gralco/click-clock-board/README.md

# click-clock-board

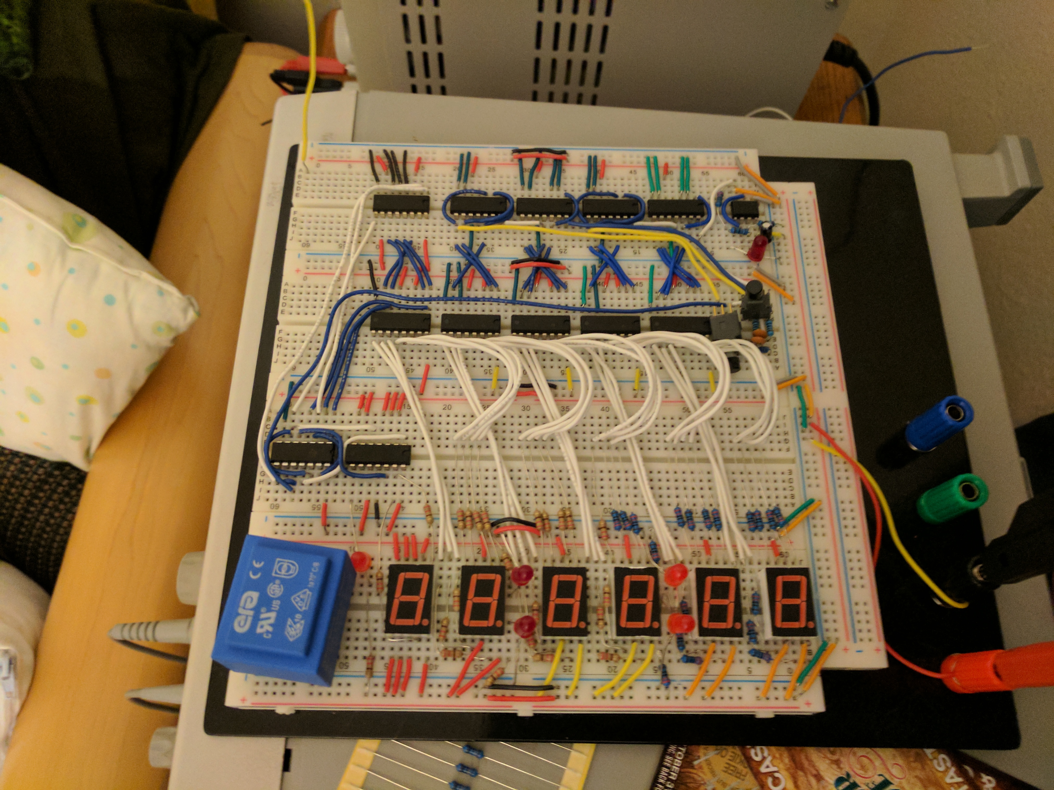
[picture p1: photos/bread_board.jpg]
Bread Board
