gralco/click-clock-board/mojo_io_shield/work/planAhead/Elevator/Elevator.runs/impl_1/.par.begin.rst

<?xml version="1.0"?>
<ProcessHandle Version="1" Minor="0">
    <Process Command="par" Owner="ekuzmenko" Host="localhost.localdomain" Pid="26856">
    </Process>
</ProcessHandle>
