gralco/click-clock-board/mojo_io_shield/work/planAhead/Elevator/Elevator.runs/synth_1/.xst.begin.rst

<?xml version="1.0"?>
<ProcessHandle Version="1" Minor="0">
    <Process Command="xst" Owner="ekuzmenko" Host="localhost.localdomain" Pid="25767">
    </Process>
</ProcessHandle>
