gralco/click-clock-board/gtkwave/hours.png

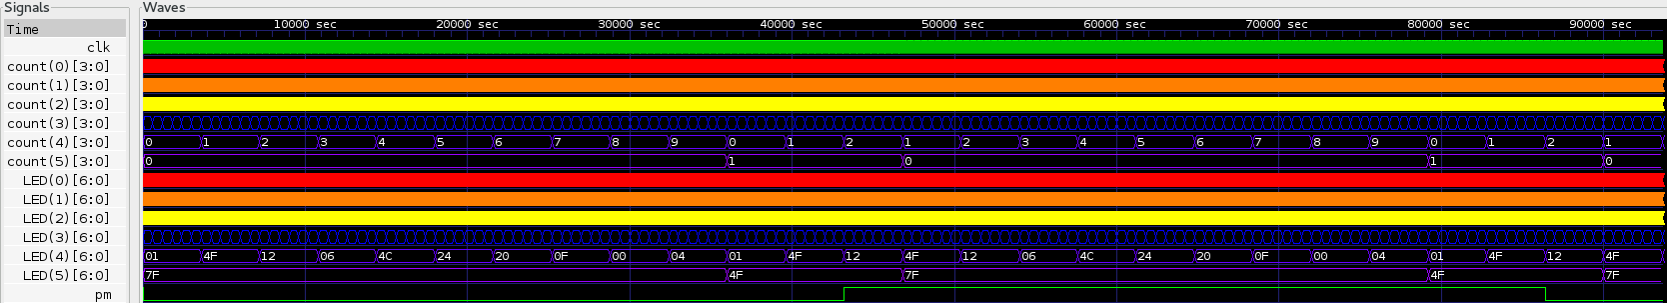
gtkwave/hours.png
