gralco/click-clock-board/gtkwave/minutes.png

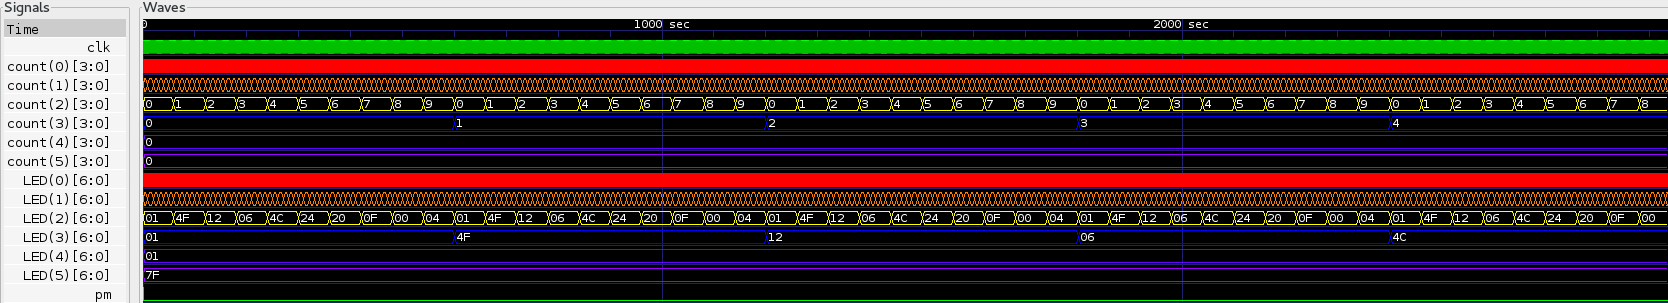
gtkwave/minutes.png
