gralco/click-clock-board/gtkwave/seconds.png

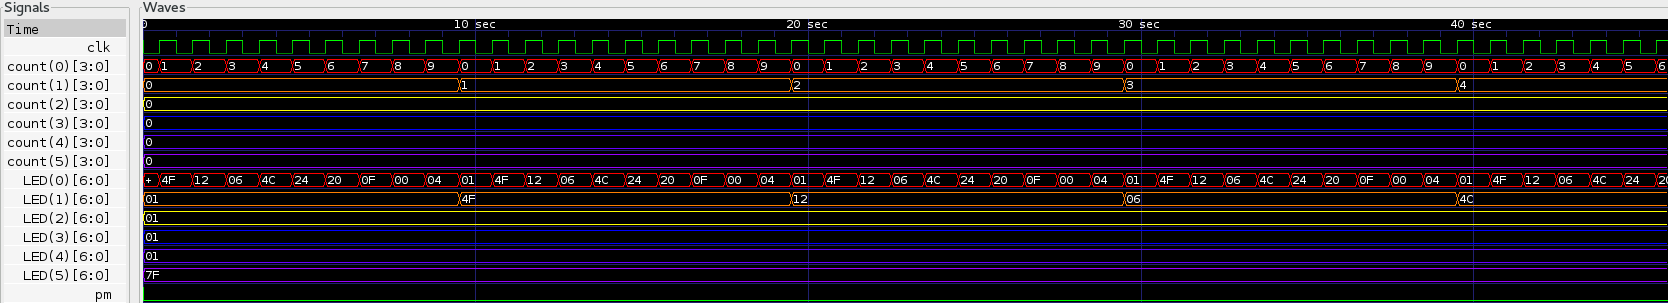
gtkwave/seconds.png
