gralco/click-clock-board/logisim/clock_bw.png

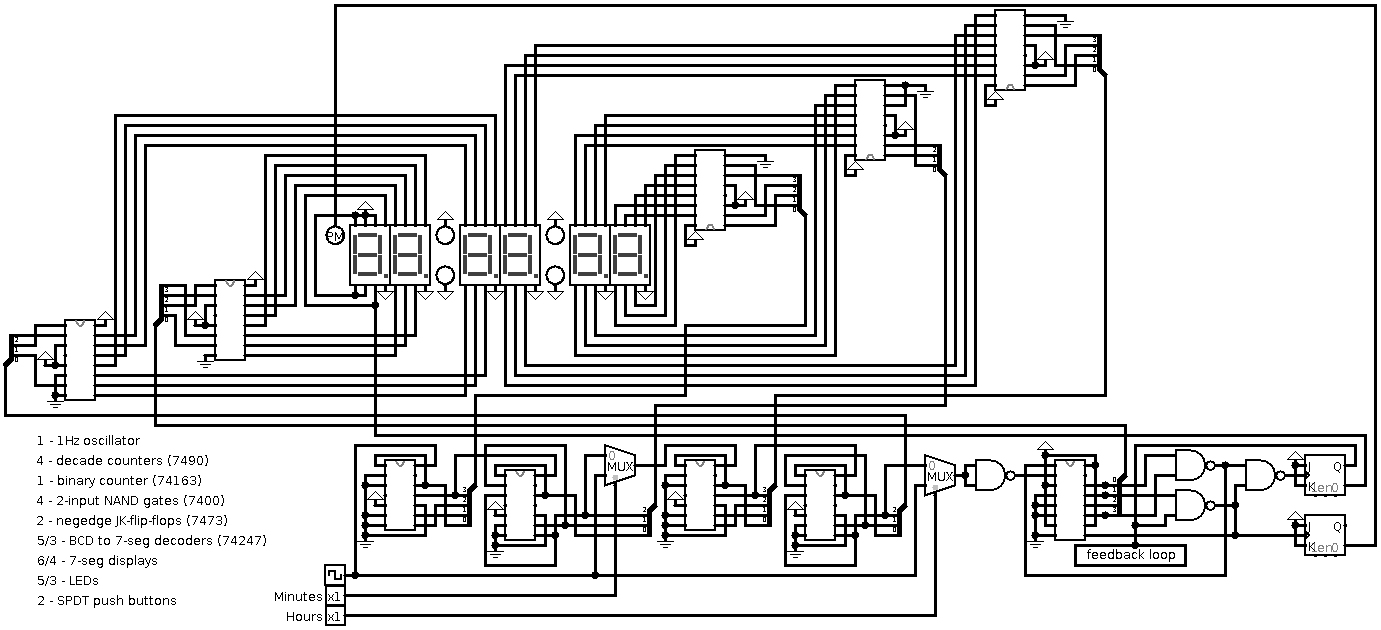
logisim/clock_bw.png
