gralco/click-clock-board/logisim/clock_color.png

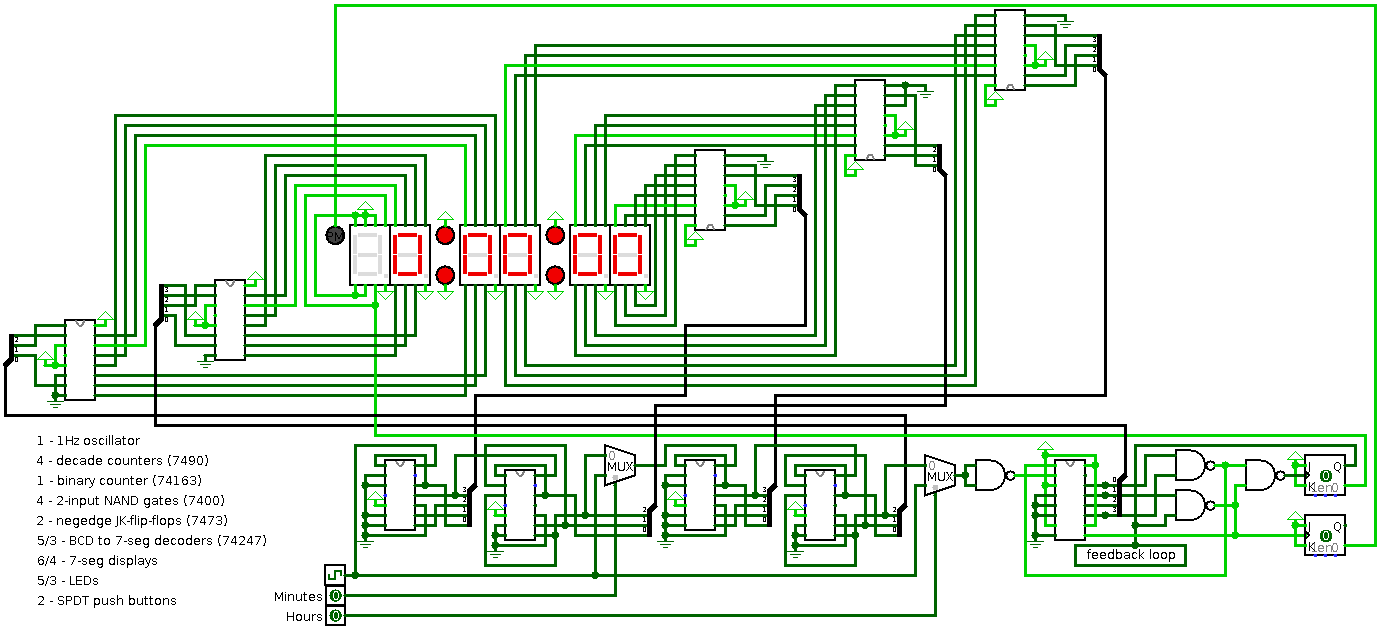
logisim/clock_color.png
