gralco/click-clock-board/psu_simulations/screenshots/cl_circuit.png

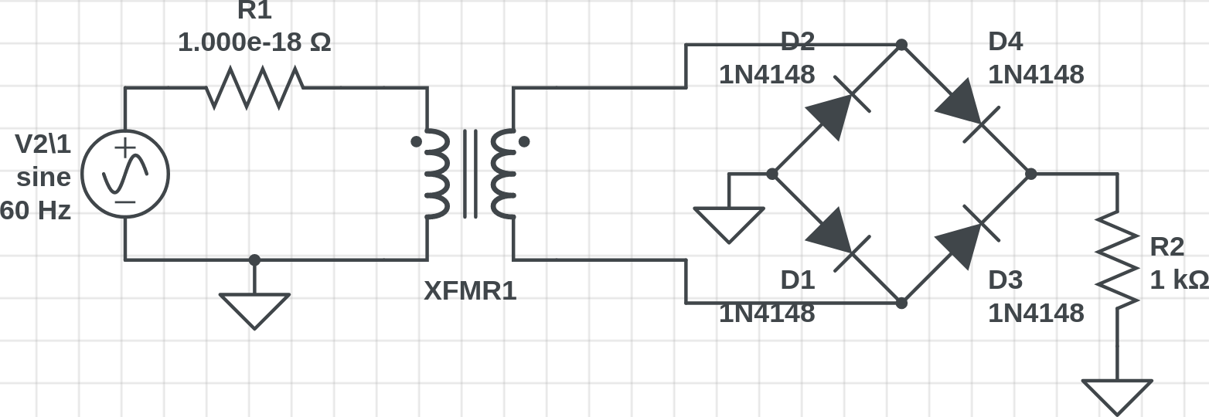
psu_simulations/screenshots/cl_circuit.png
