gralco/click-clock-board/psu_simulations/screenshots/qucs-s_circuit.png

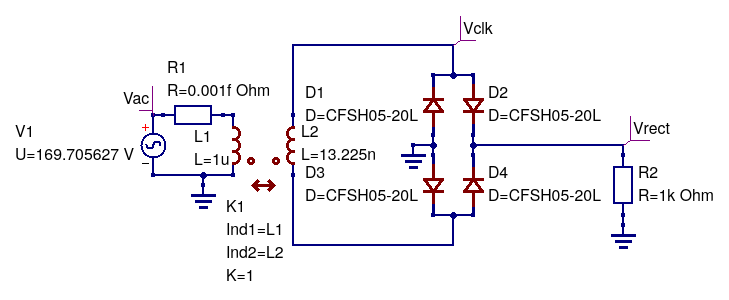
psu_simulations/screenshots/qucs-s_circuit.png
