gralco/click-clock-board/psu_simulations/screenshots/rect_qucs-s.png

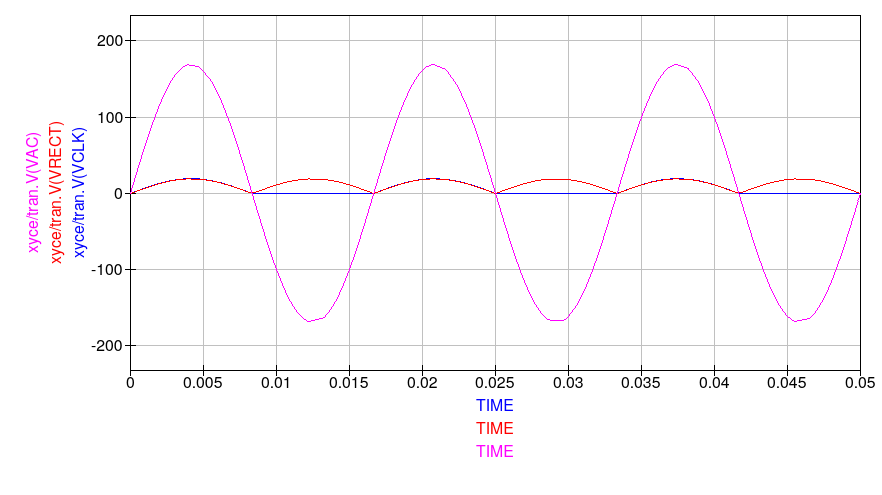
psu_simulations/screenshots/rect_qucs-s.png
