gralco/click-clock-board/psu_simulations/screenshots/Screenshot from 2017-10-19 22-39-45.png

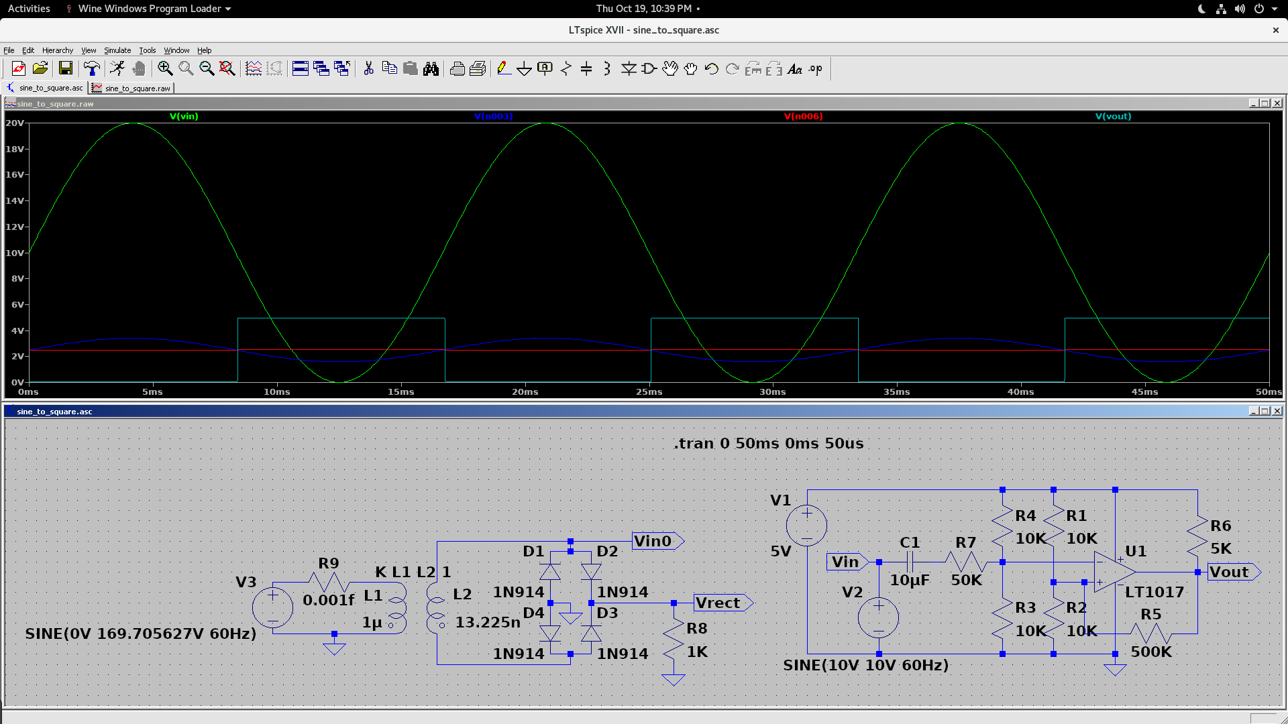
psu_simulations/screenshots/Screenshot from 2017-10-19 22-39-45.png
