gralco/click-clock-board/psu_simulations/screenshots/Screenshot from 2017-10-19 22-55-38.png

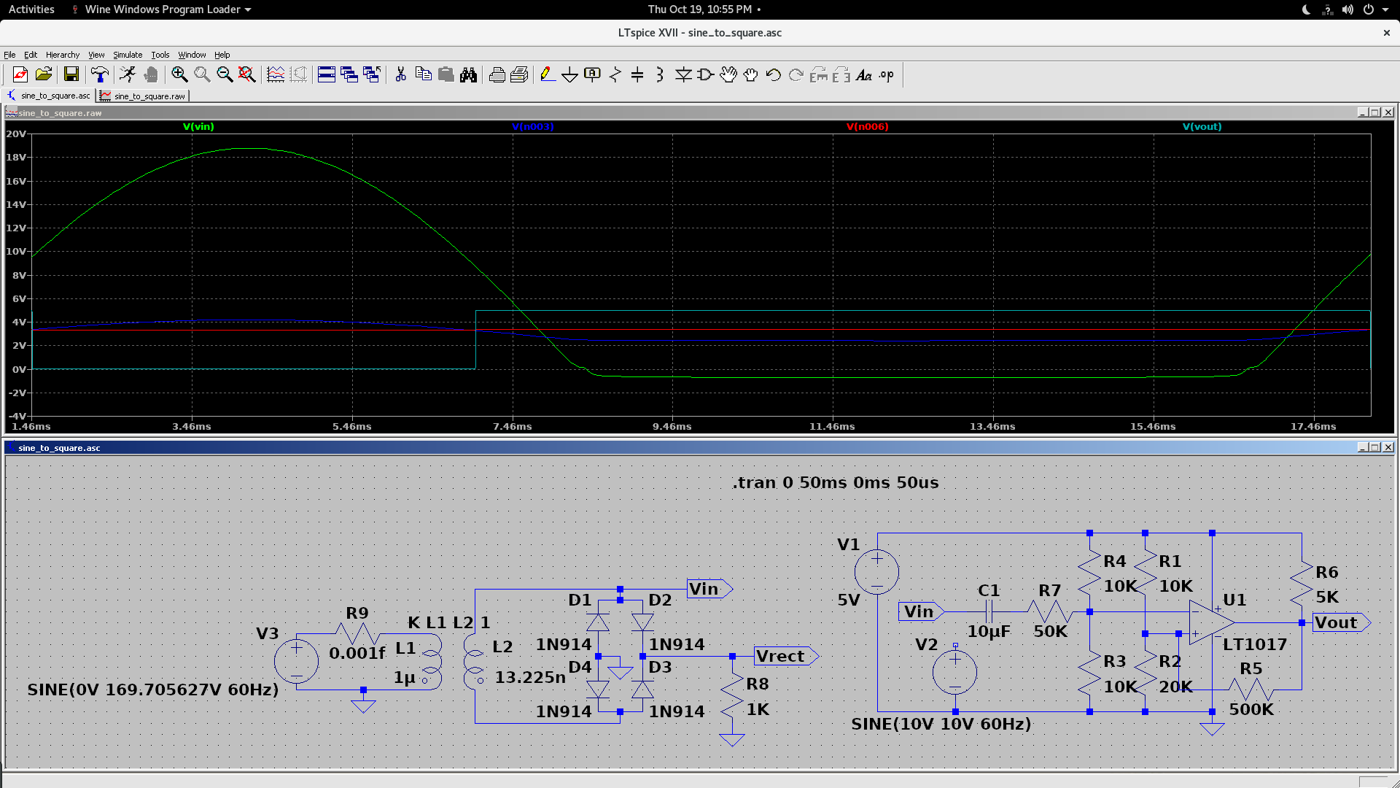
psu_simulations/screenshots/Screenshot from 2017-10-19 22-55-38.png
