gralco/click-clock-board/mojo_io_shield/work/planAhead/Elevator/Elevator.runs/impl_1/par_usage_statistics.html

Par Statistics

Total Non-vccgnd Signals=219

Total Non-vccgnd Design Pins=831

Total Non-vccgnd Conns=831

Total Non-vccgnd Timing Constrained Conns=119

Phase 1 CPU=2.2 sec

Phase 2 CPU=2.4 sec

Phase 3 CPU=2.6 sec

Phase 4 CPU=2.8 sec

Phase 5 CPU=2.9 sec

Phase 6 CPU=2.9 sec

Phase 7 CPU=2.9 sec

Phase 8 CPU=2.9 sec

Phase 9 CPU=2.9 sec

Phase 10 CPU=2.9 sec

AvgWirelenPerPin Fanout 1=2.0

AvgWirelenPerPin Fanout 2=1.5

AvgWirelenPerPin Fanout 3=1.3

AvgWirelenPerPin Fanout 4=2.2

AvgWirelenPerPin Fanout 10=3.4

AvgWirelenPerPin Fanout 50=4.0

AvgWirelenPerPin Fanout 100=0.0

AvgWirelenPerPin Fanout 500=0.0

AvgWirelenPerPin Fanout 5000=0.0

AvgWirelenPerPin Fanout 20000=0.0

AvgWirelenPerPin Fanout 50000=0.0

AvgWirelenPerPin Fanout 100000=0.0

IRR Gamma=1.0922
