gralco/click-clock-board/kicad/5v_psu_oscillator/5v_psu_oscillator.pdf

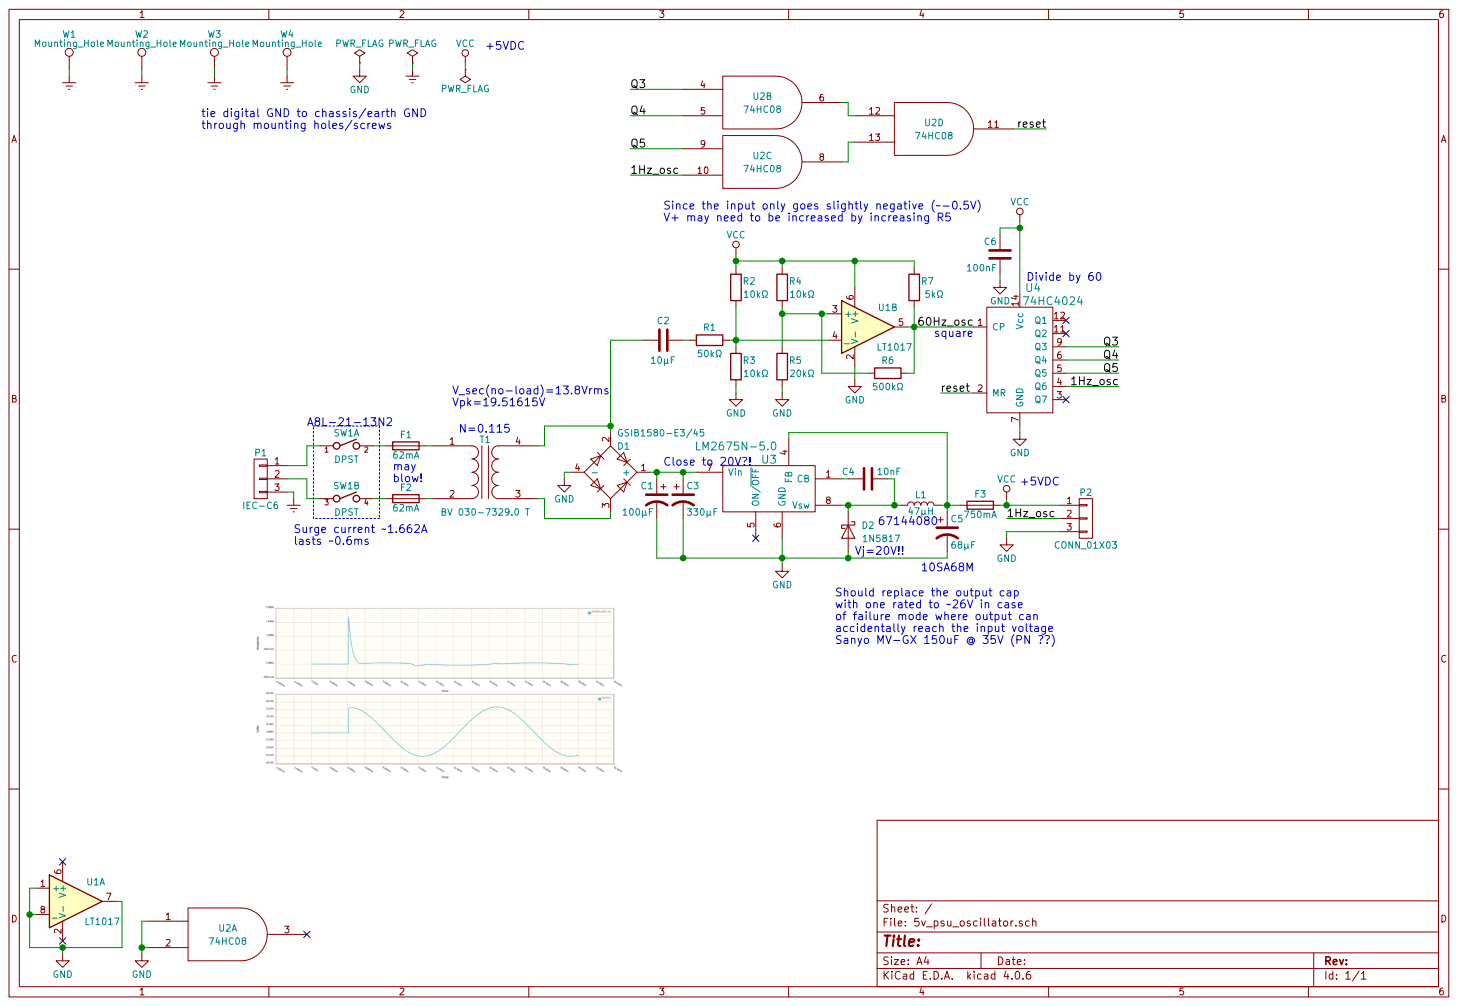
[picture p13: page 1]

tie digital GND to chassis/earth GND
through mounting holes/screws

Since the input only goes slightly negative (-0.5V)
V+ may need to be increased by increasing R5

Should replace the output cap with one rated to 26V in case
of failure mode where output can
accidentally reach the input voltage
