gralco/click-clock-board/kicad/clock/clock.pdf

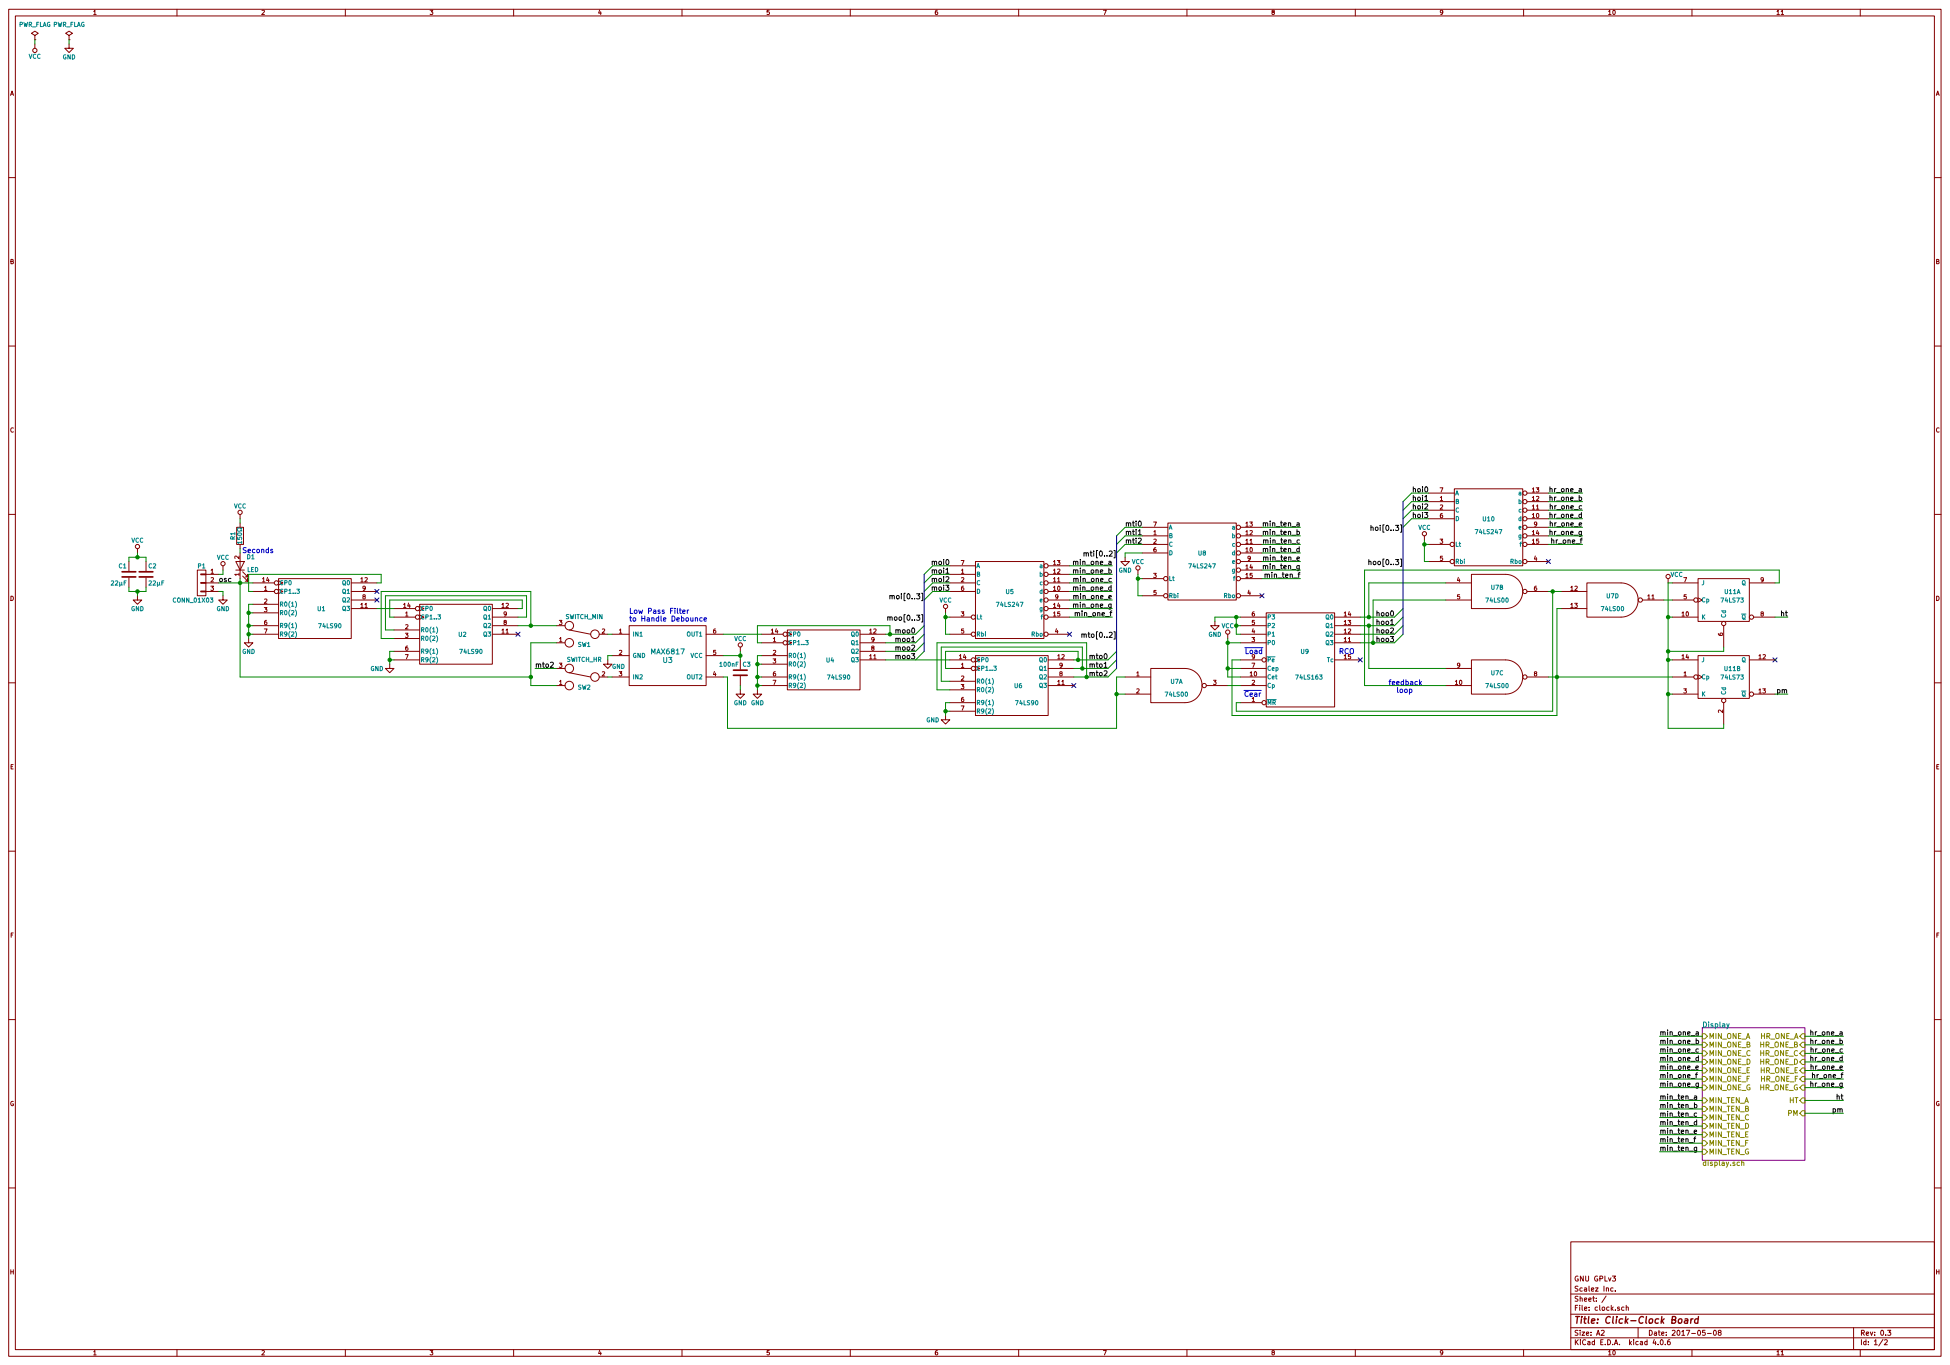
[picture p14: page 1]

File: clock.sch Sheet: / Scalez Inc. GNU GPLv3

Id: 1/2 Title: Click-Clock Board

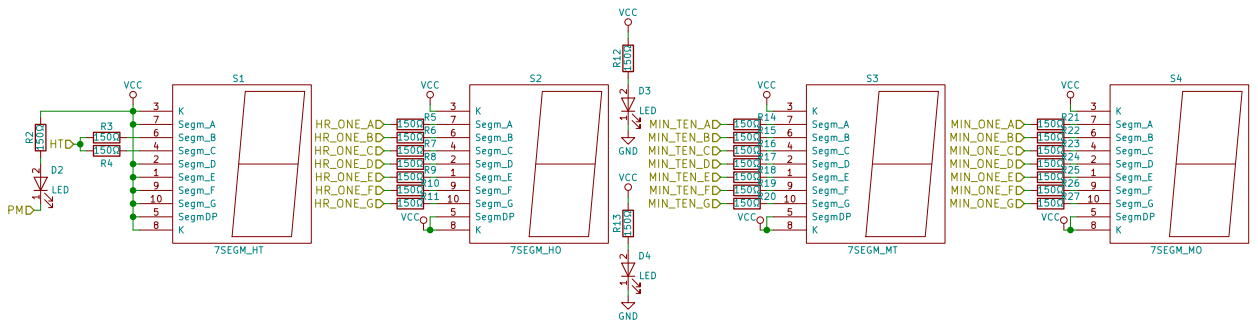
[picture p15: page 2]
