gralco/click-clock-board/psu_simulations/sine_to_square/ltspice/sine_to_square.asc

C1: cap; 10µF
D1: diode; 1N914
D2: diode; 1N914
D3: diode; 1N914
D4: diode; 1N914
L1: ind2; 1µ
L2: ind2; 13.225n
R1: res; 10K
R2: res; 20K
R3: res; 10K
R4: res; 10K
R5: res; 500K
R6: res; 5K
R7: res; 50K
R8: res; 35.217
R9: res; 0.001f
U1: LT1017
V1: voltage; 5V
V2: voltage; SINE(10V 10V 60Hz)
V3: voltage; SINE(0V 169.705627V 60Hz)
Named nets: 0, Vout, Vin, Vrect
.tran 0 50ms 0ms 50us
K L1 L2 1
