gralco/click-clock-board/(list of files, drawings)

Other design files:
logisim-evolution/clock.circ
logisim/clock.circ
