gralco/click-clock-board/kicad/clock/clock.kicad_pcb

## KiCad design kicad/clock/clock.kicad_pcb (2017-09-21)

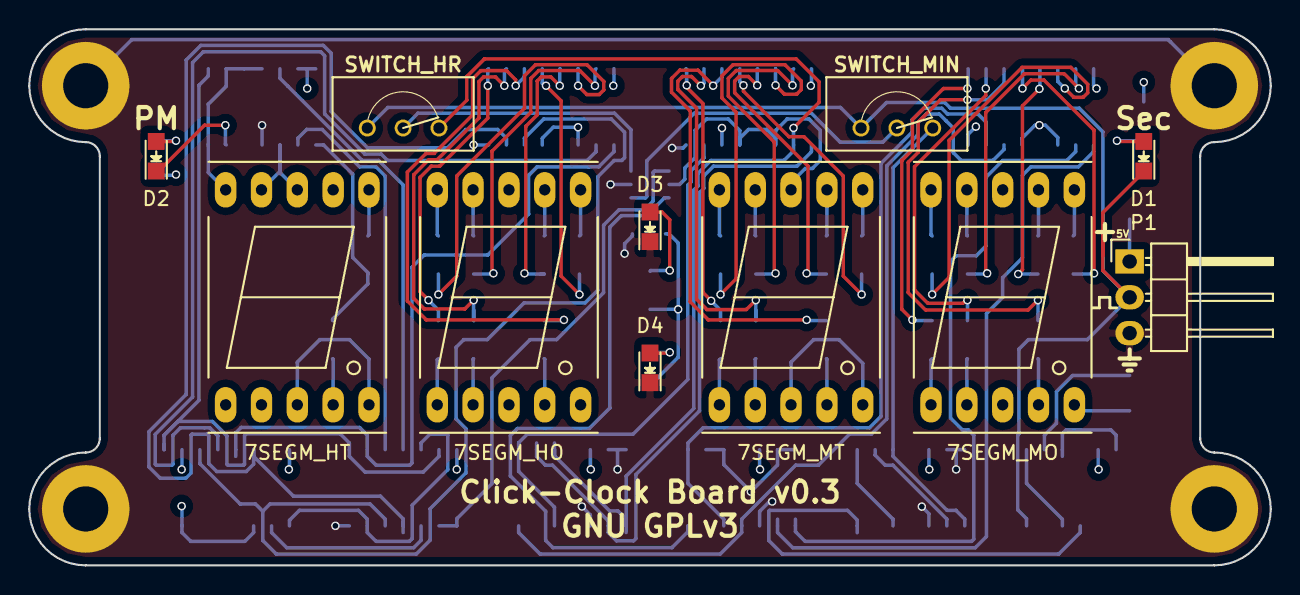
[picture p16: board clock.kicad_pcb from above]

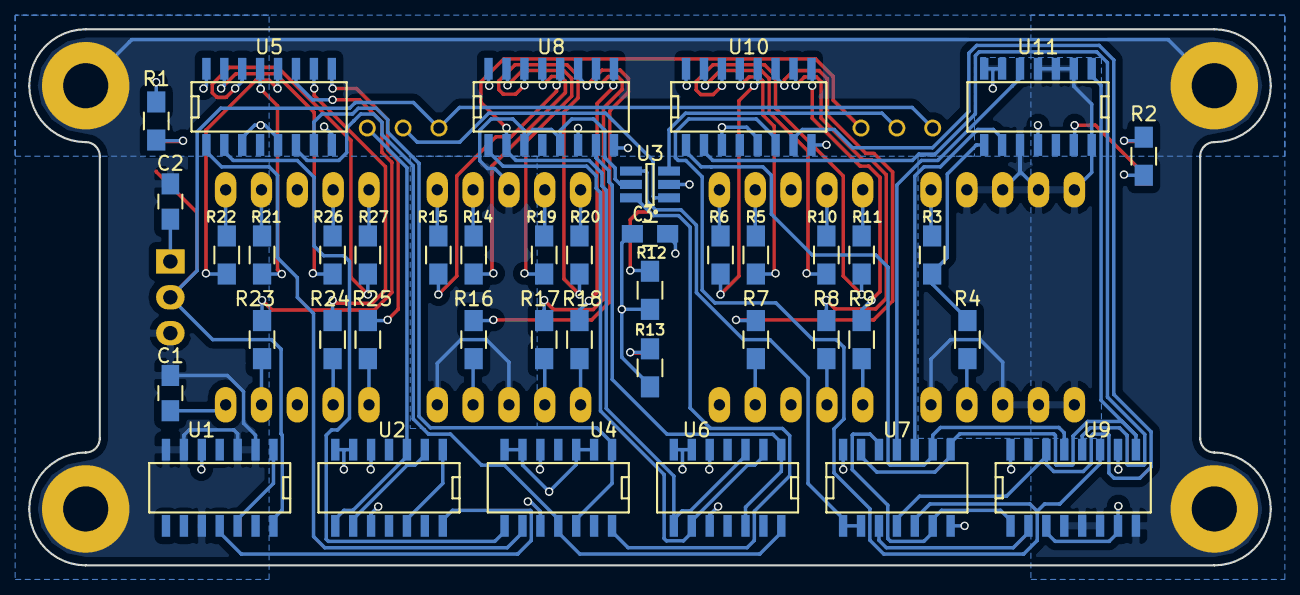
[picture p17: board clock.kicad_pcb from below]

Board: 4 copper layers, 88.0 x 38.0 mm, 52 parts (41 on the bottom side), 78 nets.

Parts:
C1, C2: 22μF; C_0805_HandSoldering
C3: 100nF; C_0805_HandSoldering
D1, D2, D3, D4: LED; LED_0805
P1: CONN_01X03; Pin_Header_Angled_1x03
R1, R2, R3, R4, R5, R6, R7, R8, R9, R10, R11, R12, R13, R14, R15, R16, R17, R18, R19, R20, R21, R22, R23, R24, R25, R26, R27: 150Ω; R_0805_HandSoldering
S1: 7SEGM_HT; 7SegmentLED_LTS6760_LTS6780
S2: 7SEGM_HO; 7SegmentLED_LTS6760_LTS6780
S3: 7SEGM_MT; 7SegmentLED_LTS6760_LTS6780
S4: 7SEGM_MO; 7SegmentLED_LTS6760_LTS6780
SW1: SWITCH_MIN; SWITCH_SPDT
SW2: SWITCH_HR; SWITCH_SPDT
U1, U2, U4, U6: 74LS90; SOIC-14
U3: MAX6817; SOT-23-6_Handsoldering
U5, U8, U10: 74LS247; SOIC-16
U7: 74LS00; SOIC-14
U9: 74LS163; SOIC-16
U11: 74LS73; SOIC-14

Connections:
/hoi0: U7.4, U9.14, U10.7
/hoi1: U7.9, U9.13, U10.1
/hoi2: U9.12, U10.2
/hoi3: U7.5, U9.11, U10.6
/hr_one_a: R5.1, U10.13
/hr_one_b: R6.1, U10.12
/hr_one_c: R7.1, U10.11
/hr_one_d: R8.1, U10.10
/hr_one_e: R9.1, U10.9
/hr_one_f: R10.1, U10.15
/hr_one_g: R11.1, U10.14
/ht: R3.1, R4.1, U11.8
/min_one_a: R21.1, U5.13
/min_one_b: R22.1, U5.12
/min_one_c: R23.1, U5.11
/min_one_d: R24.1, U5.10
/min_one_e: R25.1, U5.9
/min_one_f: R26.1, U5.15
/min_one_g: R27.1, U5.14
/min_ten_a: R14.1, U8.13
/min_ten_b: R15.1, U8.12
/min_ten_c: R16.1, U8.11
/min_ten_d: R17.1, U8.10
/min_ten_e: R18.1, U8.9
/min_ten_f: R19.1, U8.15
/min_ten_g: R20.1, U8.14
/moi0: U4.1, U4.12, U5.7
/moi1: U4.9, U5.1
/moi2: U4.8, U5.2
/moi3: U4.11, U5.6, U6.14
/mti0: U6.1, U6.12, U8.7
/mti1: U6.2, U6.9, U8.1
/mti2: SW2.3, U6.3, U6.8, U8.2
/osc: D1.1, P1.2, SW1.1, SW2.1, U1.14
/pm: D2.1, U11.13
GND: C1.2, C2.2, C3.2, D3.1, D4.1, P1.3, U1.2, U1.3, U1.6, U1.7, U1.10, U2.6, U2.7, U2.10, U3.2, U4.2, U4.3, U4.6, U4.7, U4.10, U5.8, U6.6, U6.7, U6.10, U7.7, U8.6, U8.8, U9.4, U9.5, U9.6, U9.8, U10.8, U11.11
unnamed: D1.2, R1.1
unnamed: D2.2, R2.1
unnamed: D3.2, R12.1
unnamed: D4.2, R13.1
unnamed: R3.2, S1.6
unnamed: R4.2, S1.4
unnamed: R5.2, S2.7
unnamed: R6.2, S2.6
unnamed: R7.2, S2.4
unnamed: R8.2, S2.2
unnamed: R9.2, S2.1
unnamed: R10.2, S2.9
unnamed: R11.2, S2.10
unnamed: R14.2, S3.7
unnamed: R15.2, S3.6
unnamed: R16.2, S3.4
unnamed: R17.2, S3.2
unnamed: R18.2, S3.1
unnamed: R19.2, S3.9
unnamed: R20.2, S3.10
unnamed: R21.2, S4.7
unnamed: R22.2, S4.6
unnamed: R23.2, S4.4
unnamed: R24.2, S4.2
unnamed: R25.2, S4.1
unnamed: R26.2, S4.9
unnamed: R27.2, S4.10
unnamed: SW1.2, U3.1
unnamed: SW1.3, U2.3, U2.8
unnamed: SW2.2, U3.3
unnamed: U1.1, U1.12
unnamed: U1.11, U2.14
unnamed: U2.1, U2.12
unnamed: U2.2, U2.9
unnamed: U3.4, U7.1, U7.2
unnamed: U3.6, U4.14
unnamed: U7.3, U9.2
unnamed: U7.6, U7.12, U9.1
unnamed: U7.8, U7.13, U9.9, U11.1
unnamed: U7.11, U11.5
unnamed: U7.10, U11.9
VCC: C1.1, C2.1, C3.1, P1.1, R1.2, R2.2, R12.2, R13.2, S1.1, S1.2, S1.3, S1.5, S1.7, S1.8, S1.9, S1.10, S2.3, S2.5, S2.8, S3.3, S3.5, S3.8, S4.3, S4.5, S4.8, U1.5, U2.5, U3.5, U4.5, U5.3, U5.5, U5.16, U6.5, U7.14, U8.3, U8.5, U8.16, U9.3, U9.7, U9.10, U9.16, U10.3, U10.5, U10.16, U11.2, U11.3, U11.4, U11.6, U11.7, U11.10, U11.14
