gralco/click-clock-board/(commit log)

2017-03-13 Initial commit
    Add all project data
    [clock.circ, clock.kicad_pcb, clock.sch, display.sch, mojo_top_0_routed_pad.csv, oscillator.sch]
2017-03-13 Add bread board photo
2017-03-19 Continue routing, add two layers
    [clock.kicad_pcb]
2017-03-19 Add bypass caps and route VCC
    [clock.kicad_pcb, clock.sch, display.sch]
2017-03-20 Complete layout, pass DRC, create gerbers
    [clock-B.Cu.gbl, clock-B.Mask.gbs, clock-B.SilkS.gbo, clock-Edge.Cuts.gm1, clock-F.Cu.gtl, clock-F.Mask.gts, clock-F.SilkS.gto, clock.drl]
2017-03-20 Add notes to schematic and update pcbnew view
    [clock.kicad_pcb, clock.sch]
2017-03-20 Add version and license silkscreen text
    [clock-B.Cu.gbl, clock-B.Mask.gbs, clock-B.SilkS.gbo, clock-Edge.Cuts.gm1, clock-F.Cu.gtl, clock-F.Mask.gts, clock-F.SilkS.gto, clock.drl]
2017-03-22 Realign components and make the board more symmetric
    [clock-B.Cu.gbl, clock-B.Mask.gbs, clock-B.SilkS.gbo, clock-Edge.Cuts.gm1, clock-F.Cu.gtl, clock-F.Mask.gts, clock-F.SilkS.gto, clock.drl]
2017-03-22 Optimize tack and via placement
    [clock-B.Cu.gbl, clock-B.Mask.gbs, clock-B.SilkS.gbo, clock-Edge.Cuts.gm1, clock-F.Cu.gtl, clock-F.Mask.gts, clock-F.SilkS.gto, clock.drl]
2017-03-22 Move hr_one_c bottom layer track
    [clock-B.Cu.gbl, clock-B.Mask.gbs, clock-B.SilkS.gbo, clock-Edge.Cuts.gm1, clock-F.Cu.gtl, clock-F.Mask.gts, clock-F.SilkS.gto, clock.drl]
2017-03-22 Bring In2.Cu tracks to F.Cu, make In2.Cu pour VCC and F.Cu GND, add pour to the B.Cu left side to GND
    [clock-B.Cu.gbl, clock-B.Mask.gbs, clock-B.SilkS.gbo, clock-Edge.Cuts.gm1, clock-F.Cu.gtl, clock-F.Mask.gts, clock-F.SilkS.gto, clock.drl]
2017-03-22 Add more GND pour to the bottom layer
    [clock-B.Cu.gbl, clock-B.Mask.gbs, clock-B.SilkS.gbo, clock-Edge.Cuts.gm1, clock-F.Cu.gtl, clock-F.Mask.gts, clock-F.SilkS.gto, clock.drl]
2017-03-22 Update overlapping back pour and set their priority levels
    [clock-B.Cu.gbl, clock-B.Mask.gbs, clock-B.SilkS.gbo, clock-Edge.Cuts.gm1, clock-F.Cu.gtl, clock-F.Mask.gts, clock-F.SilkS.gto, clock.drl]
2017-03-22 More routing improvements
    [clock-B.Cu.gbl, clock-B.Mask.gbs, clock-B.SilkS.gbo, clock-Edge.Cuts.gm1, clock-F.Cu.gtl, clock-F.Mask.gts, clock-F.SilkS.gto, clock.drl]
2017-03-23 Add BoM, update component info, use 150Ohm current limiting resistors, update layout respectively
    [clock.csv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]
2017-03-24 Format the BoM to be more organized, add .ods BoM spreadsheet
    [clock.csv, clock.ods]
2017-03-24 Update 7-seg and sw BoM values
    [clock.csv, clock.ods]
2017-03-24 Update pdf of the schematics
2017-03-24 Add small keep-out zone around pin 8 GND via of U10
    [clock-B.Cu.gbl, clock-B.Mask.gbs, clock-B.SilkS.gbo, clock-Edge.Cuts.gm1, clock-F.Cu.gtl, clock-F.Mask.gts, clock-F.SilkS.gto, clock.drl]
2017-03-24 Reduce U9's VCC trace length to pin 3
    [clock-B.Cu.gbl, clock-B.Mask.gbs, clock-B.SilkS.gbo, clock-Edge.Cuts.gm1, clock-F.Cu.gtl, clock-F.Mask.gts, clock-F.SilkS.gto, clock.drl]
2017-03-24 Reduce the trace length going to pin 2 of SWITCH_MIN
    [clock-B.Cu.gbl, clock-B.Mask.gbs, clock-B.SilkS.gbo, clock-Edge.Cuts.gm1, clock-F.Cu.gtl, clock-F.Mask.gts, clock-F.SilkS.gto, clock.drl]
2017-03-24 Optimize more tracks
    [clock-B.Cu.gbl, clock-B.Mask.gbs, clock-B.SilkS.gbo, clock-Edge.Cuts.gm1, clock-F.Cu.gtl, clock-F.Mask.gts, clock-F.SilkS.gto, clock.drl]
2017-03-24 Shorten U1's pin 1 to 12 track
    [clock-B.Cu.gbl, clock-B.Mask.gbs, clock-B.SilkS.gbo, clock-Edge.Cuts.gm1, clock-F.Cu.gtl, clock-F.Mask.gts, clock-F.SilkS.gto, clock.drl]
2017-03-24 Use the same routing path for U1, U2, and U4's pin 1 to 12 connection
    [clock-B.Cu.gbl, clock-B.Mask.gbs, clock-B.SilkS.gbo, clock-Edge.Cuts.gm1, clock-F.Cu.gtl, clock-F.Mask.gts, clock-F.SilkS.gto, clock.drl]
2017-04-02 Move track going to pin 3 of SW1
    [clock-B.Cu.gbl, clock-B.Mask.gbs, clock-B.SilkS.gbo, clock-Edge.Cuts.gm1, clock-F.Cu.gtl, clock-F.Mask.gts, clock-F.SilkS.gto, clock.drl]
2017-04-02 Update netlist after changing resistor values from 220Ohms to 150Ohms
    [clock.kicad_pcb, clock.sch, display.sch]
2017-04-03 Close up some copper pour gaps
    [clock-B.Cu.gbl, clock-B.Mask.gbs, clock-B.SilkS.gbo, clock-Edge.Cuts.gm1, clock-F.Cu.gtl, clock-F.Mask.gts, clock-F.SilkS.gto, clock.drl]
2017-04-03 Brint input D of U8 to GND
    Was floating
    [clock-B.Cu.gbl, clock-B.Mask.gbs, clock-B.SilkS.gbo, clock-Edge.Cuts.gm1, clock-F.Cu.gtl, clock-F.Mask.gts, clock-F.SilkS.gto, clock.drl]
2017-04-03 Swap pin 1 and 3 of the SPDT push button footprint and update layout accordingly
    [clock-B.Cu.gbl, clock-B.Mask.gbs, clock-B.SilkS.gbo, clock-Edge.Cuts.gm1, clock-F.Cu.gtl, clock-F.Mask.gts, clock-F.SilkS.gto, clock.drl]
2017-04-03 Make 74163's clk label pos-edge
    [clock.circ]
2017-04-04 Further optimize the routing
    [clock-B.Cu.gbl, clock-B.Mask.gbs, clock-B.SilkS.gbo, clock-Edge.Cuts.gm1, clock-F.Cu.gtl, clock-F.Mask.gts, clock-F.SilkS.gto, clock.drl]
2017-04-08 Scooch a few tracks
    [clock-B.Cu.gbl, clock-B.Mask.gbs, clock-B.SilkS.gbo, clock-Edge.Cuts.gm1, clock-F.Cu.gtl, clock-F.Mask.gts, clock-F.SilkS.gto, clock.drl]
2017-04-08 Set the mounting hole pitch to be 80mm x 30mm
    [clock-B.Cu.gbl, clock-B.Mask.gbs, clock-B.SilkS.gbo, clock-Edge.Cuts.gm1, clock-F.Cu.gtl, clock-F.Mask.gts, clock-F.SilkS.gto, clock.drl]
2017-04-08 Update LED symbol to new KiCad library symbol
    [clock.kicad_pcb, clock.sch, display.sch]
2017-04-08 Update switch silkscreen text
    [clock-B.Cu.gbl, clock-B.Mask.gbs, clock-B.SilkS.gbo, clock-Edge.Cuts.gm1, clock-F.Cu.gtl, clock-F.Mask.gts, clock-F.SilkS.gto, clock.drl]
2017-04-08 Move R2 such that it's position from the mounting hole on X is the same as R1
    [clock-B.Cu.gbl, clock-B.Mask.gbs, clock-B.SilkS.gbo, clock-Edge.Cuts.gm1, clock-F.Cu.gtl, clock-F.Mask.gts, clock-F.SilkS.gto, clock.drl]
2017-04-08 Move R12, R13, and C3's VCC track
    [clock-B.Cu.gbl, clock-B.Mask.gbs, clock-B.SilkS.gbo, clock-Edge.Cuts.gm1, clock-F.Cu.gtl, clock-F.Mask.gts, clock-F.SilkS.gto, clock.drl]
2017-04-08 Move U7's pin 8 trace
    [clock-B.Cu.gbl, clock-B.Mask.gbs, clock-B.SilkS.gbo, clock-Edge.Cuts.gm1, clock-F.Cu.gtl, clock-F.Mask.gts, clock-F.SilkS.gto, clock.drl]
2017-04-08 Move U11's pin 2 to pin 14 VCC trace
    [clock-B.Cu.gbl, clock-B.Mask.gbs, clock-B.SilkS.gbo, clock-Edge.Cuts.gm1, clock-F.Cu.gtl, clock-F.Mask.gts, clock-F.SilkS.gto, clock.drl]
2017-04-08 Expand bottom keepout near U5's GND pin 8
    [clock-B.Cu.gbl, clock-B.Mask.gbs, clock-B.SilkS.gbo, clock-Edge.Cuts.gm1, clock-F.Cu.gtl, clock-F.Mask.gts, clock-F.SilkS.gto, clock.drl]
2017-04-08 Clean up tracks and vias
    [clock-B.Cu.gbl, clock-B.Mask.gbs, clock-B.SilkS.gbo, clock-Edge.Cuts.gm1, clock-F.Cu.gtl, clock-F.Mask.gts, clock-F.SilkS.gto, clock.drl]
2017-04-08 Center U5, U8, U10, and U11's silkscreen designator
    [clock-B.Cu.gbl, clock-B.Mask.gbs, clock-B.SilkS.gbo, clock-Edge.Cuts.gm1, clock-F.Cu.gtl, clock-F.Mask.gts, clock-F.SilkS.gto, clock.drl]
2017-04-08 Reduce min_one_e top layer track length
    [clock-B.Cu.gbl, clock-B.Mask.gbs, clock-B.SilkS.gbo, clock-Edge.Cuts.gm1, clock-F.Cu.gtl, clock-F.Mask.gts, clock-F.SilkS.gto, clock.drl]
2017-05-01 Add 5V power supply with oscillator circuit
    [5v_psu_oscillator.kicad_pcb, 5v_psu_oscillator.sch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]
2017-05-01 Associate more footprints
    [5v_psu_oscillator.sch]
2017-05-09 Connect the left and right sides of the B.Cu ground pour
    Increment rev to 0.3
    Add title and license to sheet rev block
    [clock-B.Cu.gbl, clock-B.Mask.gbs, clock-B.SilkS.gbo, clock-Edge.Cuts.gm1, clock-F.Cu.gtl, clock-F.Mask.gts, clock-F.SilkS.gto, clock.drl]
2017-09-21 Update the C and R WRL 3D model filenames
    [clock.kicad_pcb]
2017-10-11 Associate some more footprints
    [5v_psu_oscillator.sch]
2017-10-20 Add new 5V psu and oscillator simulation projects/data, include additional 100uFinput capacitor to the buck converter for less input ripple
    [5v_psu_oscillator.sch, test15.sch]
2024-01-13 Add Logisim Evolution file
    [clock.circ]
